ChipCE/IPMI-card/README.md

# IPMI-card
## To-do ( v3 )
1.Switch from ESP8266 to Raspberry Zero W
2.Add remote control via ssh

## To-do ( v3 lite )
1.Simple power control only using esp8266
