ChipCE/IPMI-card/std/Doc/outline.md

# PC遠隔制御(IPMI)カードの構築
## 1 はじめに
IPMIとはサーバのCPU、バス、ファン、温度センサ、電源、ファンなどの基本コンポーネントの監視や遠隔制御などを行うためのインターフェースである。しかし、市販のIPMIカードは特定のサーバマザーボードにしか対応しない。
本研究では一般ザーボードに対応できるIPMIモジュールを構築する。
## 2 システム構成
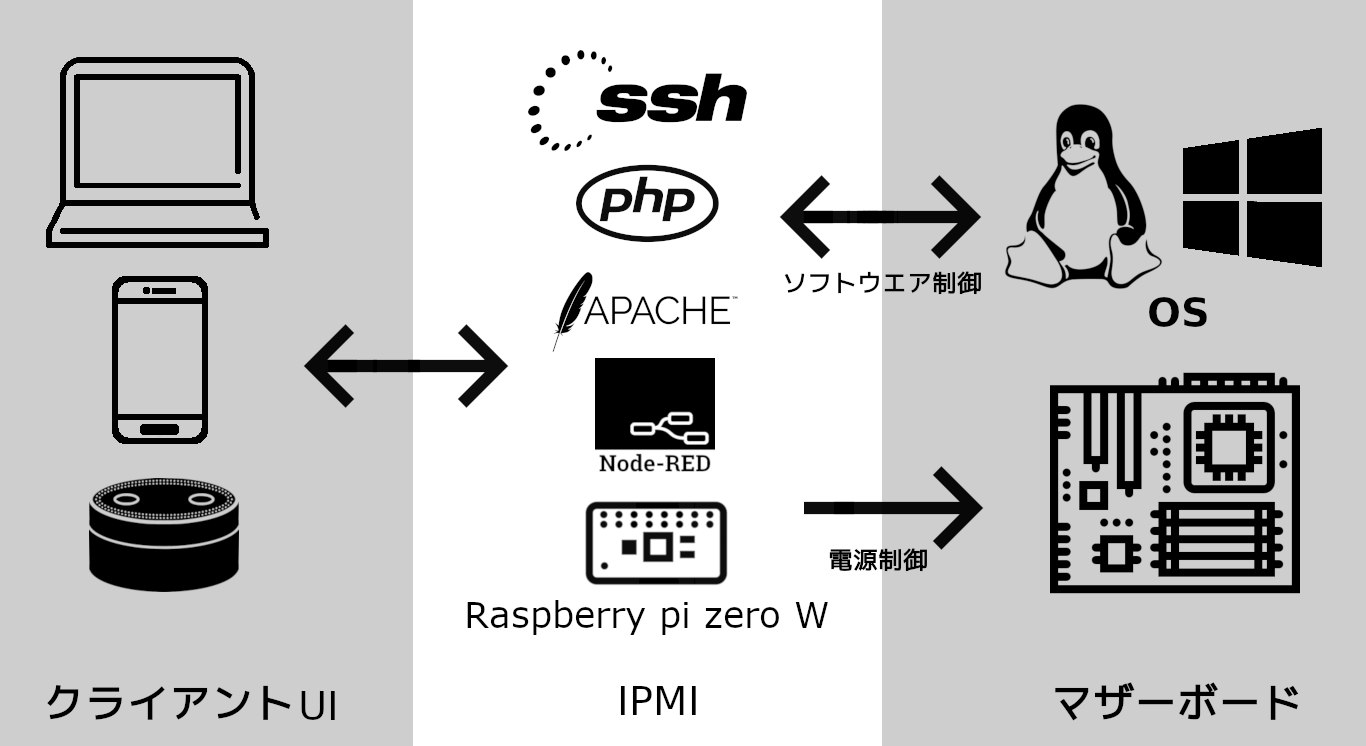
[picture p1: std/Doc/img/sys-map.png]

<center>図1．システム構成図</center>
- クライアントUI   
クライアントはスマホ、パソコンなどの端末でSSH、又はHttpプロトコルによってサーバーとデータをやり取りする。データの内容はホストPCの電源状態、IPMIモジュールの接続状態、ホストPCに実行させたい命令、命令実行の結果。
- IPMI   
IPMIモジュールはホストPCと独立の電源を使用、マザーボードの電源スイッチを物理的に操作することによって、ホストPCの電源状態と関係なく制御することができる。また、IPMIモジュールはUSBネットワークインタフェースとしてホストPCに接続することで、ホストPCがネットワークに接続しない状態でも遠隔操作ができる。
Apache+Php（ウエブサーバー）でクライアント端末にウエブインタフェースを提供する。スマートスピーカに関する処理はNode-redで行う。
使用可能なインタフェース：SSH,ウエブ
- ホストPC   
ホストPCはSSHプロトコルでIPMIモジュールから命令を受取、命令の実行結果をIPMIモジュールに送る。

## 3 ハードウェア制御
### 3.1 電源スイッチ制御回路
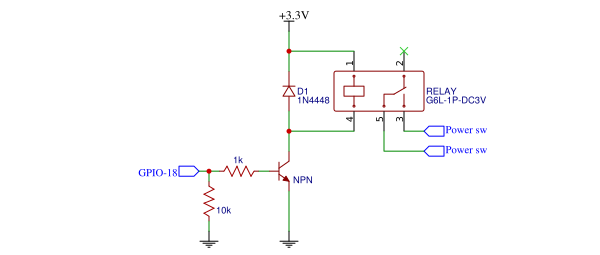
[picture p2: std/Doc/img/schem-relay.png]

<center>図2．電源制御回路図</center>
ホストPCの電源状態と関係なく制御するために、物理的にマザーボードの電源スイッチを操作することが必要と考えられる。電源スイッチを制御するためにリレーを用いる。リレーは電源スイッチと並列に接続する。リレーはホストPCの電源スイッチと並列接続することで、スイッチの機能を保ちながら、ホストPCの電源を制御することができる。
Raspberry Zero W GPIOの出力電力が低く、直接リレーを制御できないため、NPNトランジスタスイッチ回路リレーを制御する。
Raspberry Zero WのGPIO-18の初期化状態はINPUT－PULLDOWN（入力・プルダウン）ため、IPMIモジュールの起動、再起動ときにリレーの誤動作を生じないため、ホストPCの誤動作を防ぐことができる。

### 3.2 電源状態監視回路
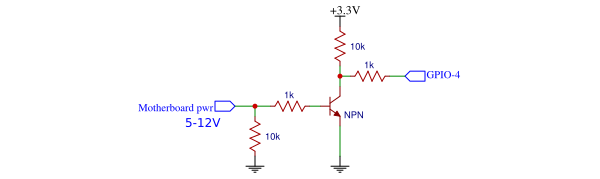
[picture p3: std/Doc/img/schem-monitor.png]

<center>図3．電源監視回路図</center>
マザーボードによって、電源を切ったときにも５Vバースに電源が供給される場合があるため。5VバースでホストPCの電源状態を判定できないときは12VバースでホストPCの電源状態を判定する。Raspberry Zeroの最大入力可能電圧は3.3Vのため、直接5v、12Vバースに直接接続せず、NPNトランジスタスイッチ回路で電源状態の判定を行う。NPNトランジスタスイッチ回路を使用することで入力電圧を大幅に対応することができる。

### 3.3 基板設計
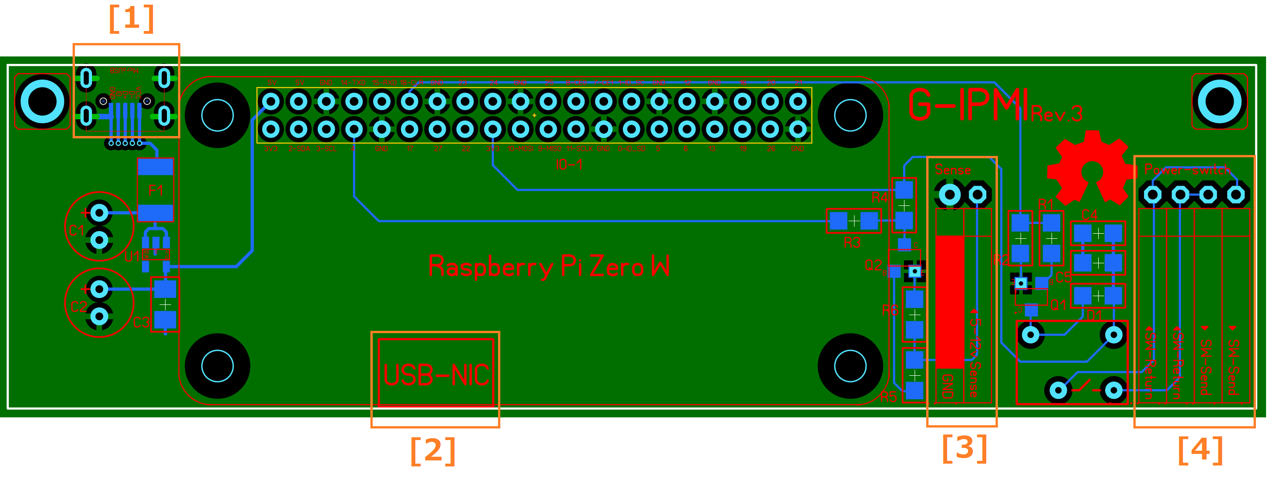
[picture p4: std/Doc/img/pcb.png]

<center>図4．基板設計図</center>
[1]電源入力：コネクタータイプはmicroUSB、電圧5v 電流 1000 mA以上
[2]Raspberryネットワークインターフェース:マザーボードのUSBヘッダに接続
[3]電源状態監視:マザーボードの電源スイッチヘッダやケースの電源スイッチに
接続
[4]電源スイッチ制御:マザーボードの5v、⼜は12v電源に接続
## 4 ソフトウェア制御
### 4.1 コマンドラインインターフェース(CLI)
ホストPCを遠隔操作するためにSSHプロトコルを利用する。ipmiモジュールにインストールされたipmiツールでほすとPCの電源やソフトウエア制御を行う。　　　
使用可能なコマンドライン:
- start :  ホストPCを起動する。
- stop :　ホストPCをシャットダウンする。
- restart : ホストPCを再起動する。
- status : ホストPCの状態を表示する。
- setup : ipmiモジュールの設定を行う。ホストPCをアクセスためのIPアドレスやWebインターフェースアクセスためのパスワードを変更することができる。
- shell : ホストPCのソフトウェア制御を行う。ホストPCがWindowsの場合はPowershell、Linuxの場合はbash/zshに接続する。
- version : ipmiのソフトウェアバージョンを表示。
- help : ipmiのマニュアルを表示。
- -f シャットダウン、再起動を強制に実行。シャットダウン、再起動の命令を実行後、一定の時間たってもホストPCの電源状態が変化しないとき強制的に電源を切る。
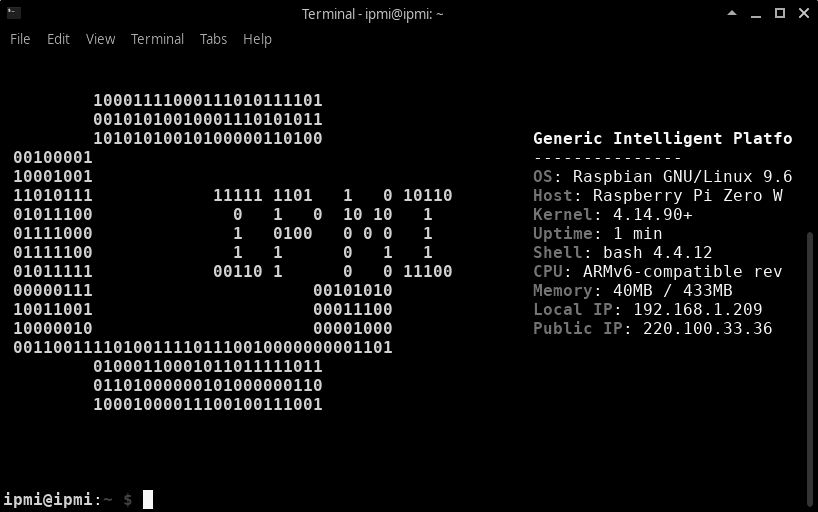
[picture p5: std/Doc/img/pc-cli-home.png]

<center>図5．パソコンのCLI</center> 
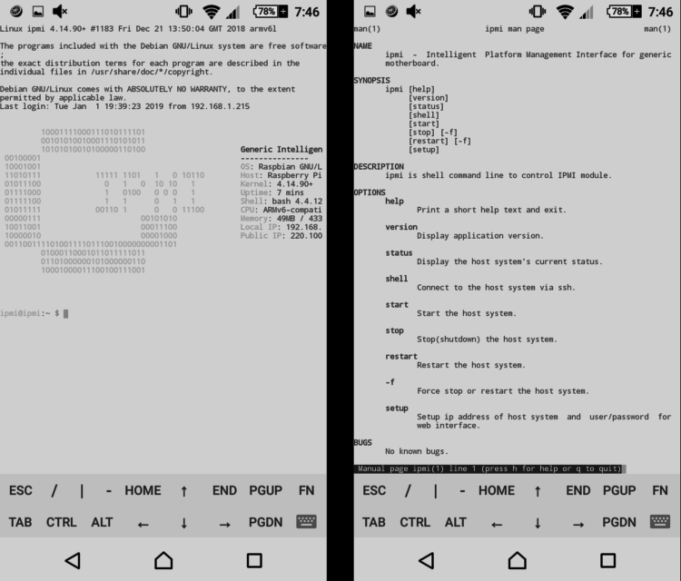
[picture p6: std/Doc/img/mobile-cli-all.png]

<center>図6．スマートフォンのCLI(ssh juiceアプリを利用)</center>

### 4.2 Webインインターフェース
WebインインターフェースでホストPCの監視や電源制御を行うことができる。WebインインターフェースはBootstrapフレームワークを利用することでアクセス端末の画面サイズによって適切なレイアウトを提供する。
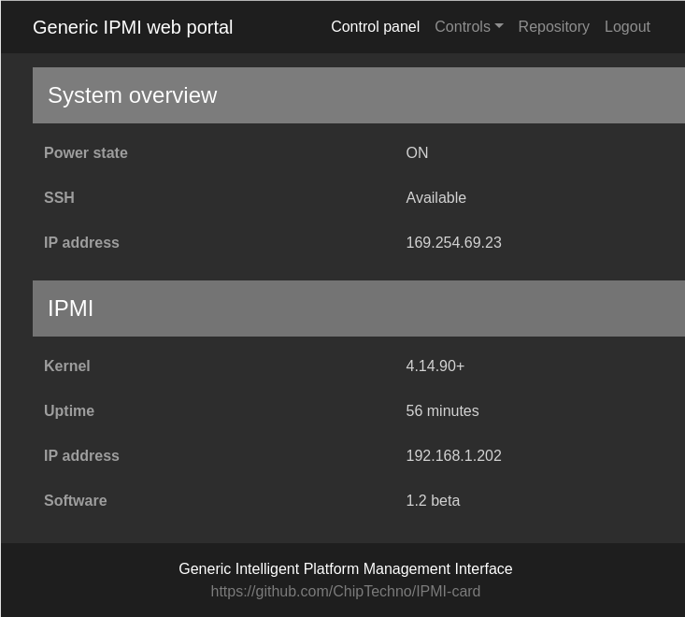
[picture p7: std/Doc/img/pc-web.png]

<center>図7．パソコンのWebインインターフェース</center>
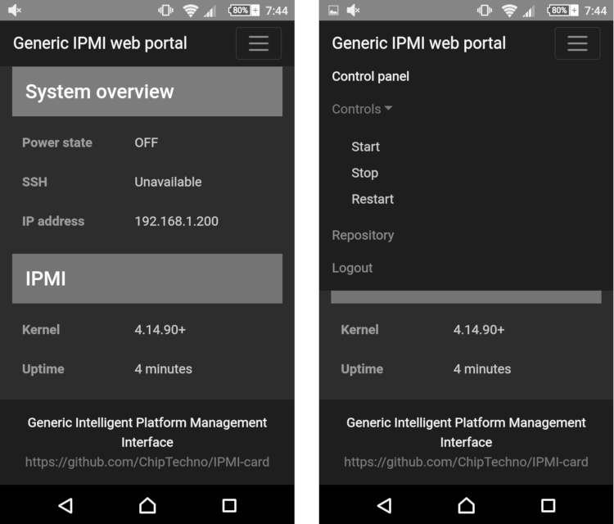
[picture p8: std/Doc/img/mobile-web-all.png]

<center>図8．スマートフォンのWebインインターフェース</center>

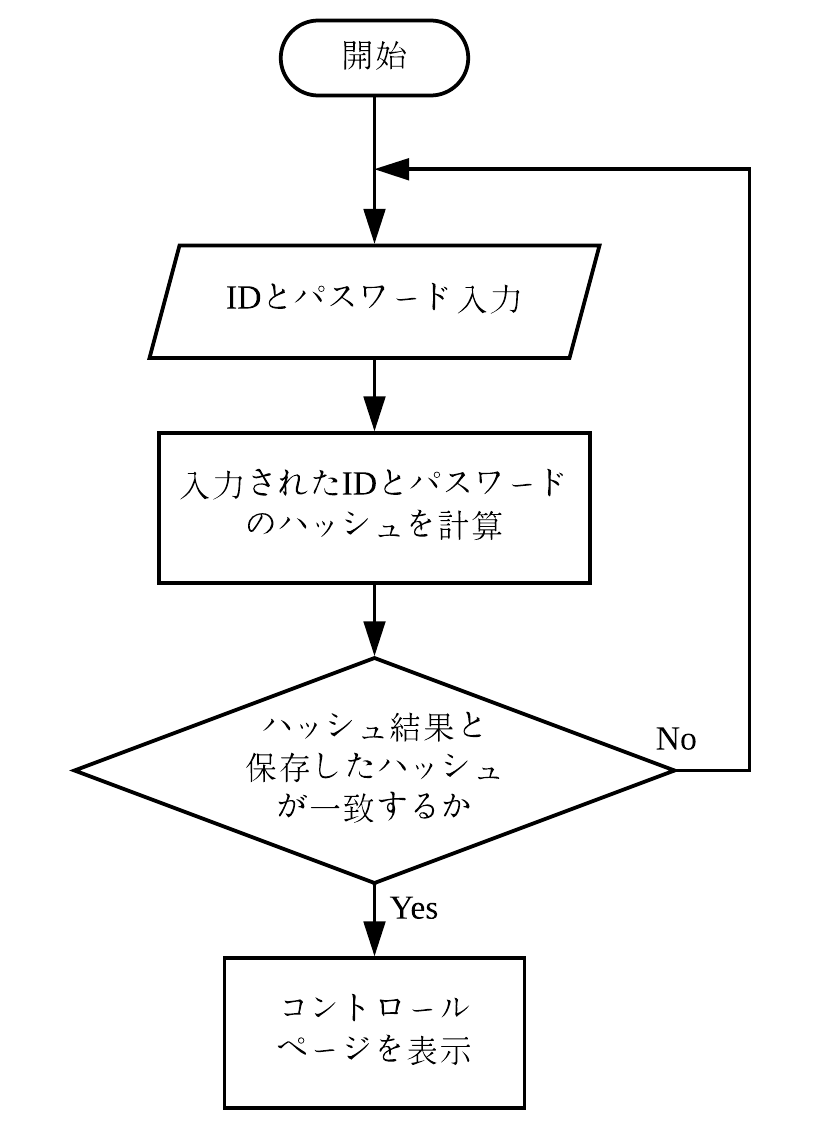
[picture p9: std/Doc/img/web-flowchart.png]
ipmi-flowchart

<center>図9.Webインタフェースの認証フローチャート</center>
WebインインターフェースをアクセスためにCLIと別のパスワードを入力することが必要。WebインインターフェースのIDやパスワードの設定はipmiのsetup機能で設定することができる。設定されたIDとパスワードはSHA256のハッシュ関数で暗号化しIPMIモジュールの設定ファイルに保存する。ユーザがIDとパスワードを入力したとき、そのIDとパスワードをSHA256のハッシュ関数で暗号化し、その結果を保存したハッシュ数を比較する。計算ハッシュと保存ハッシュが一致する場合、コントロールぺページに移動、一致しない場合は再入力を求める。

### 4.3 スマートスピーカーインインターフェース
スマートスピーカーインインターフェースはnoderedを利用、スマートスピーカーとの連携を行う。スマートスピーカーの音声認識機能でホストPCの電源制御を行うことができる。
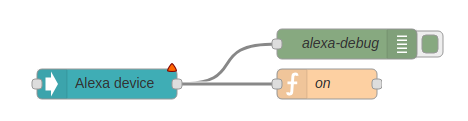
[picture p10: std/Doc/img/nodered.png]

<center>図10．NoderedによるAmazon echoとの連携</center>

## 6 動作確認
### 6.1 ペネトレーション・脆弱性テスト
ペネトレーションテストはroutersploit/autopwnを使い、ipmiモジュールの脆弱性を検知するを行った。2019年1月7日の実行は「脆弱性が発見されなかった(could not confirm any vulnerablity.)」という結果を得た。

ipmi-flowchart
<center>図11．routersploit/autopwnによるペネトレーション・脆弱性テスト結果</center>

### 6.2 消費電力測定
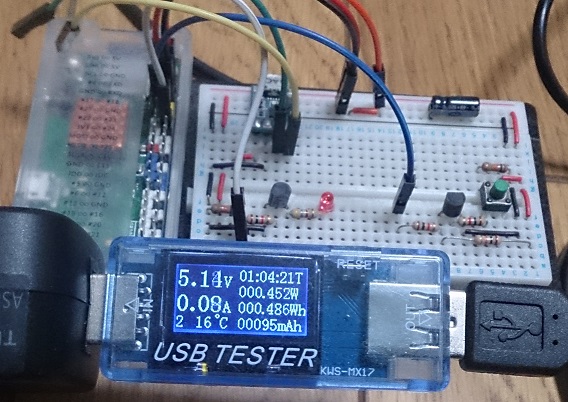
[picture p11: std/Doc/img/power-consumption.png]

<center>図12．消費電力テスト結果</center>

## 5 まとめ
本研究でRaspberry Zero Wを用いてパソコン遠隔操作装置（IPMI）の構築を行った。作成した装置で、ホストPCの電源やネットワーク状態と関係なく遠隔操作を行うことができた。
　本研究で使用したRaspberry Zero WはネットワークインターフェースカードとしてホストPCのマザーボードに接続するため、OSが起動する前（BIOS）段階で電源制御以外の遠隔操作機能は使用できない。今後の課題として、Biosの設定画面にも遠隔操作を行うことができれば、利便性が向上すると考えられる。

## 参考文献
[1] BCM2835-ARMデータシート
https://www.raspberrypi.org/app/uploads/2012/02/BCM2835-ARM-Peripherals.pdf(2018年12月1日閲覧)
[2] routersploit/autopwnによるペネトレーションテストツール(2019年1月8日閲覧)
https://github.com/threat9/routersploit
