ChipCE/IPMI-card/std/Doc/final/memo.md

# Memo

## To be include in main.md

- web auth flow chart
- power control flow chart
- sys schematic (gpio control and ideal diode)
- Security test
- Control test
- install script map
- device specs
- linux gpio group

## fix

- enable nodered and apache systemd service
- cleanup echo from code
- check version in web,shell,man,python scripts
