ChipCE/IPMI-card/std/Doc/final/参考文献-謝辞.docx

参考文献

[1] BCM2835-ARMデータシート

https://www.raspberrypi.org/app/uploads/2012/02/BCM2835-ARM-Peripherals.pdf

(2018年12月1日閲覧)

[2] routersploit/autopwnペネトレーションテストツール

https://github.com/threat9/routersploit

(2019年1月8日閲覧)

[3] Bootstrap 4 API

https://getbootstrap.com/docs/4.1/getting-started/introduction/

(2019年1月8日閲覧)

[4] Raspberry Pi ドキュメント

https://www.raspberrypi.org/documentation/

(2019年1月8日閲覧)

謝辞

本研究を進めるにあたり、研究設備を整えて下さり、また終始懇切丁寧にご指導・ご助言下さった、山本政宏先生に心より深く感謝し、お礼申し上げます。

また、様々なご意見をいただきました先輩方々や同級生の方々に深く感謝いたします。
