ChipCE/IPMI-card/std/Doc/final/付録目次.docx

付録目次

1. index.php 1
2. ipmi-bridge.php 5
3. login-action.php 6
4. login.php 　　 7
5. logout.php 10
6. msg.php 11
7. style.css 14
8. IPMI man 16
9. Neofetch config 18
10. Neofetch 21
11. IPMI config 22
12. ipmi.py 23
13. ipmi.sh 27
14. setup.sh 32
