ChipCE/IPMI-card/std/Doc/final/本文目次.docx

目次

1 はじめに 1
2 システム構成 2
3 電源制御 3
4 コマンドラインインターフェース 4
5 ウェブインターフェース 8
6 スマートスピーカーインターフェース 10
7 動作テスト 11
8 回路設計 16
9 まとめ 17

参考文献

謝辞

付録
