ChipCE/IPMI-card/std/Doc/final/表紙.docx

2019年度　卒業論文

PC遠隔制御(IPMI)カードの構築

関東学院大学　理工学部理工学科

情報ネット・メディアコース

山本研究室

215K6036 グェンミントゥ
