ChipCE/IPMI-card/std/Doc/img/access-key.png

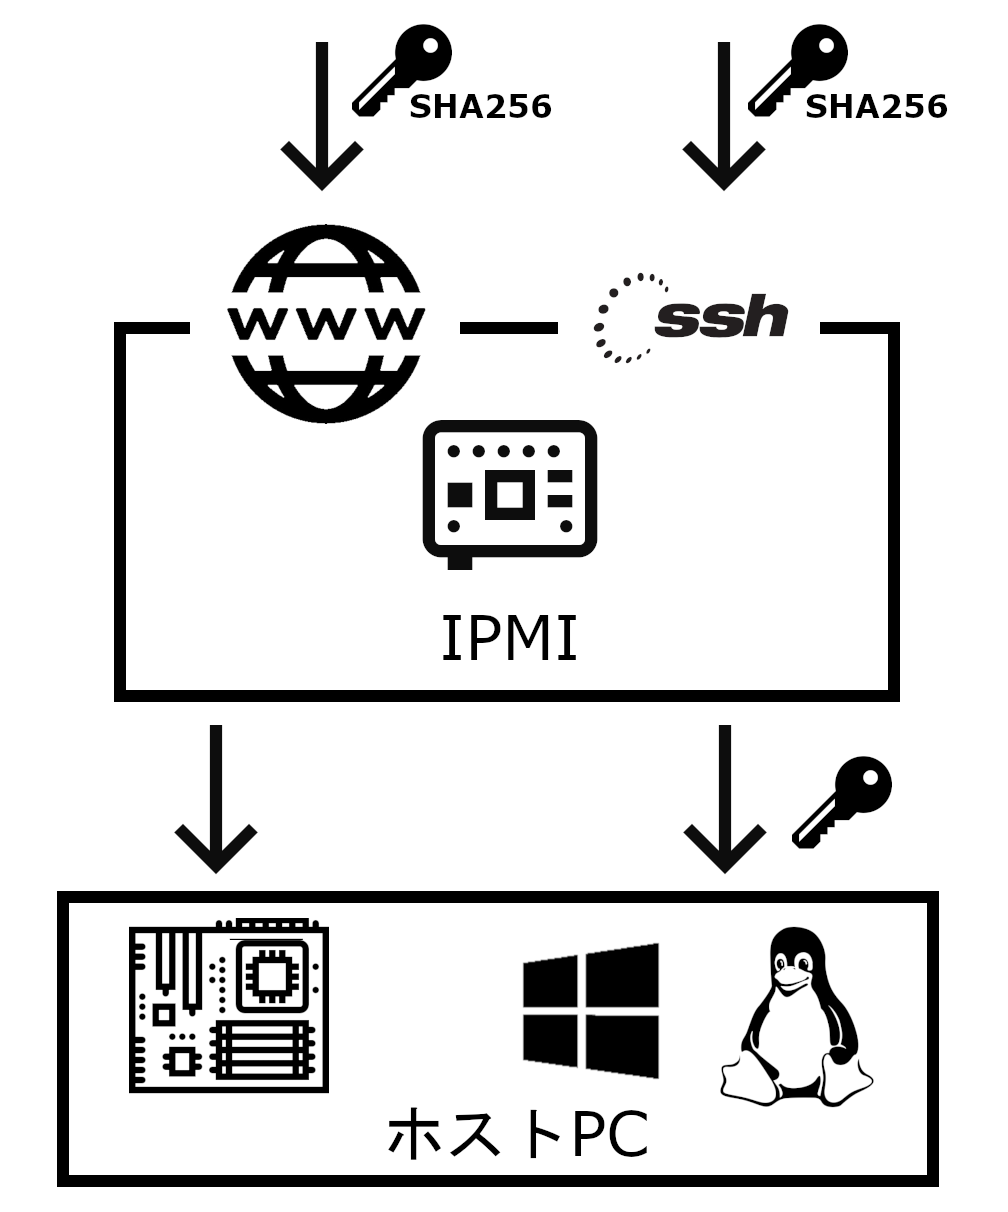
std/Doc/img/access-key.png
