ChipCE/IPMI-card/std/Doc/img/esp8266.png

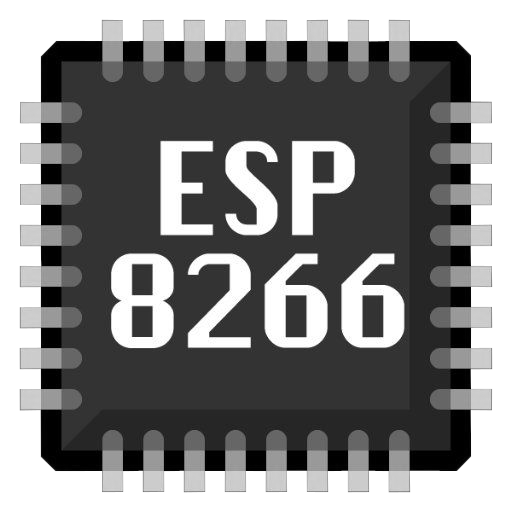
std/Doc/img/esp8266.png
