ChipCE/IPMI-card/std/Doc/img/hp-ipmi-back-front.jpg

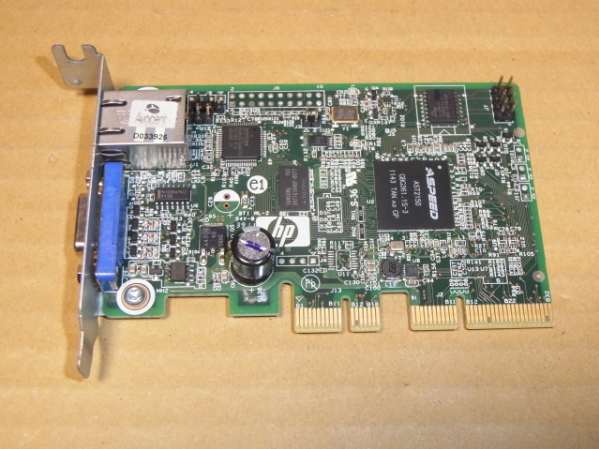
std/Doc/img/hp-ipmi-back-front.jpg
