ChipCE/IPMI-card/std/Doc/img/hp-ipmi-back.jpg

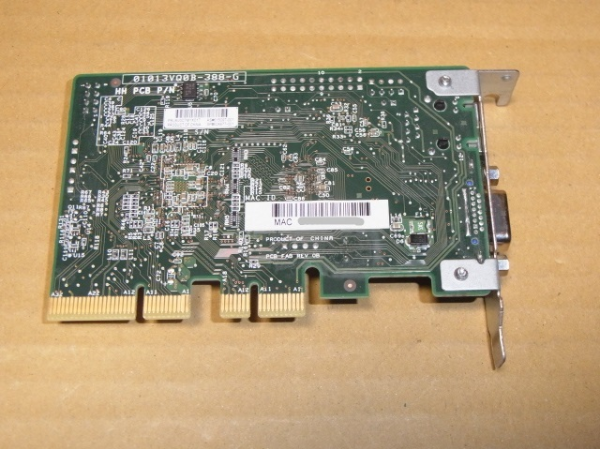
std/Doc/img/hp-ipmi-back.jpg
