ChipCE/IPMI-card/std/Doc/img/hp-ipmi.jpg

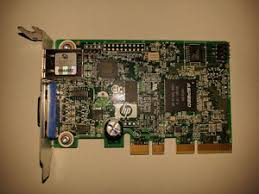
std/Doc/img/hp-ipmi.jpg
