ChipCE/IPMI-card/std/Doc/img/mobile-cli-home.png

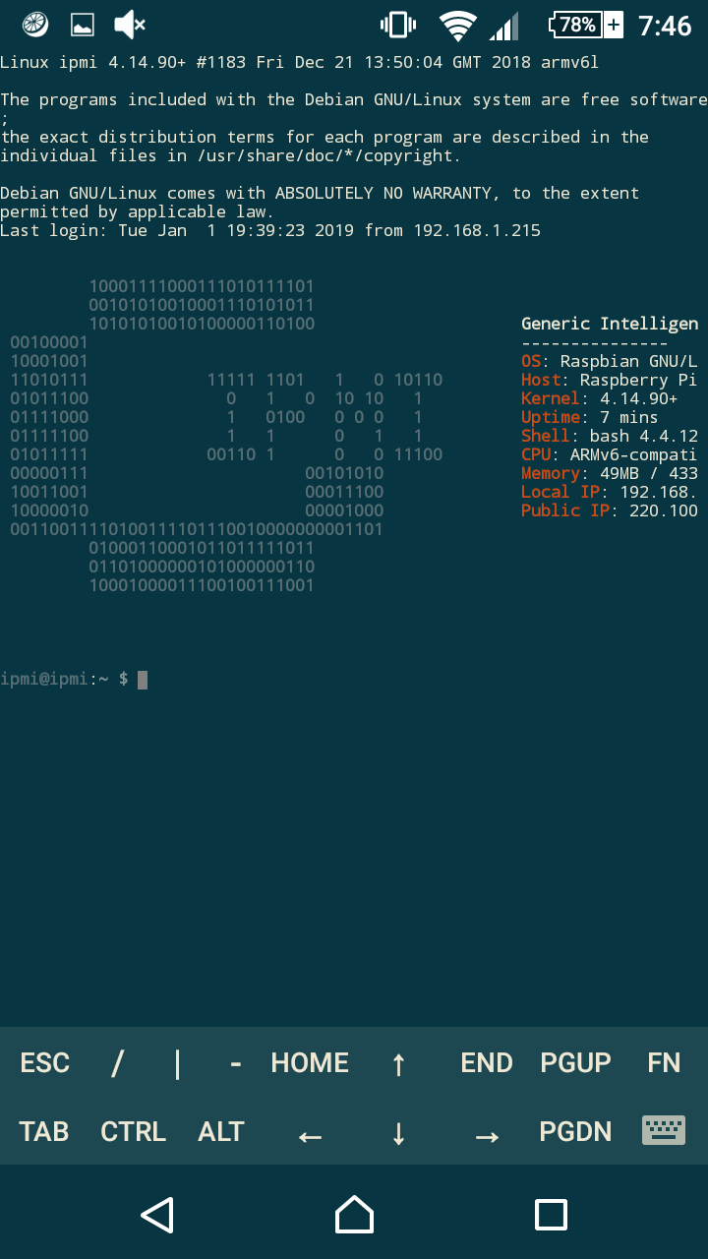
std/Doc/img/mobile-cli-home.png
