ChipCE/IPMI-card/std/Doc/img/mobile-cli-man.png

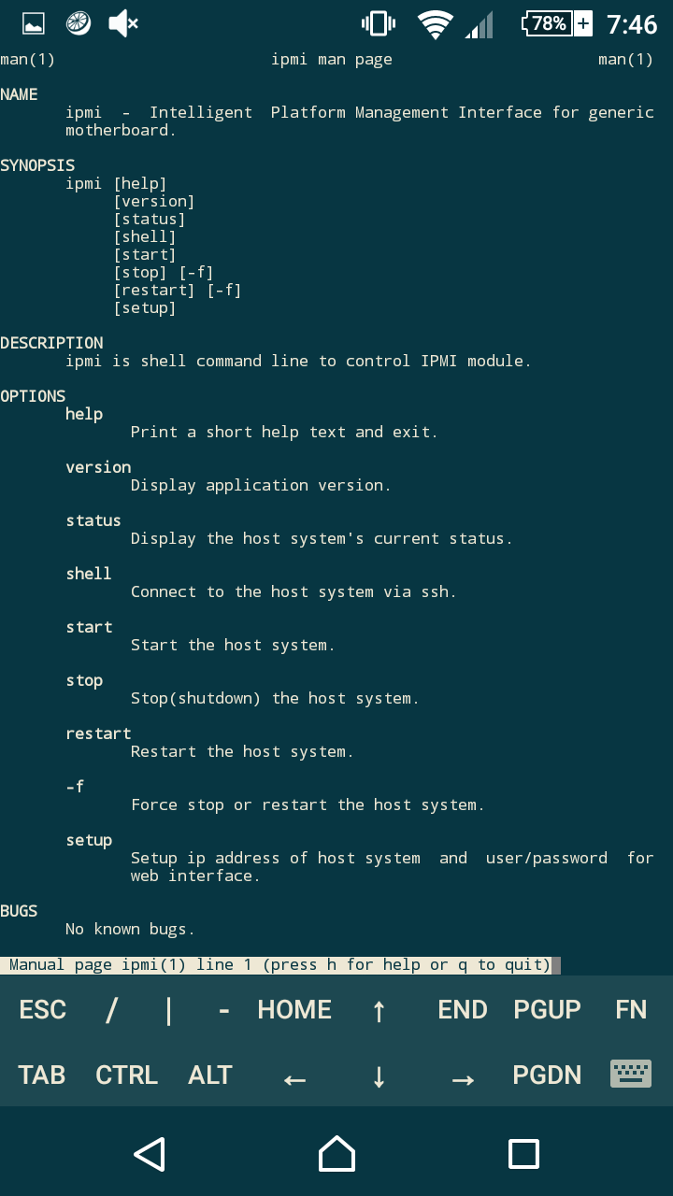
std/Doc/img/mobile-cli-man.png
