ChipCE/IPMI-card/std/Doc/img/mobile-web-control.png

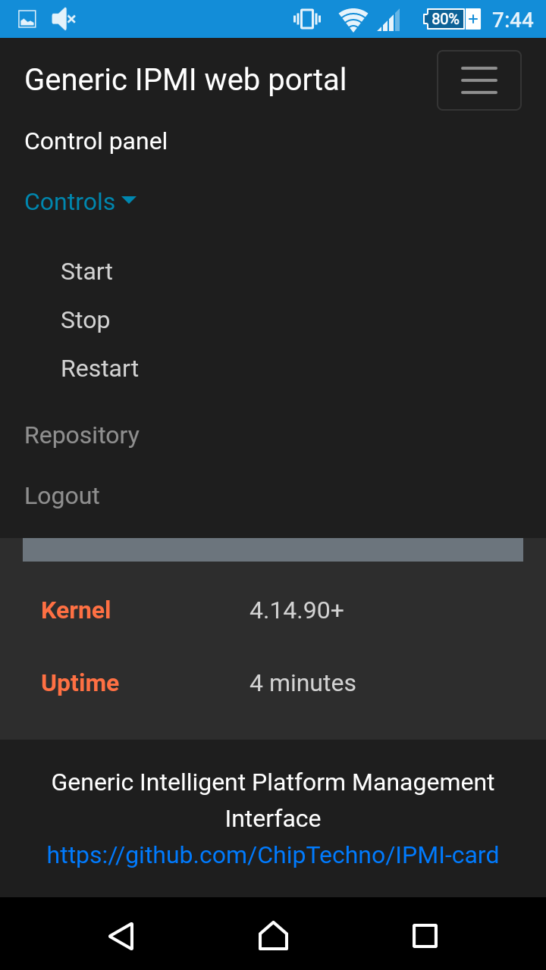
std/Doc/img/mobile-web-control.png
