ChipCE/IPMI-card/std/Doc/img/mobile-web-home.png

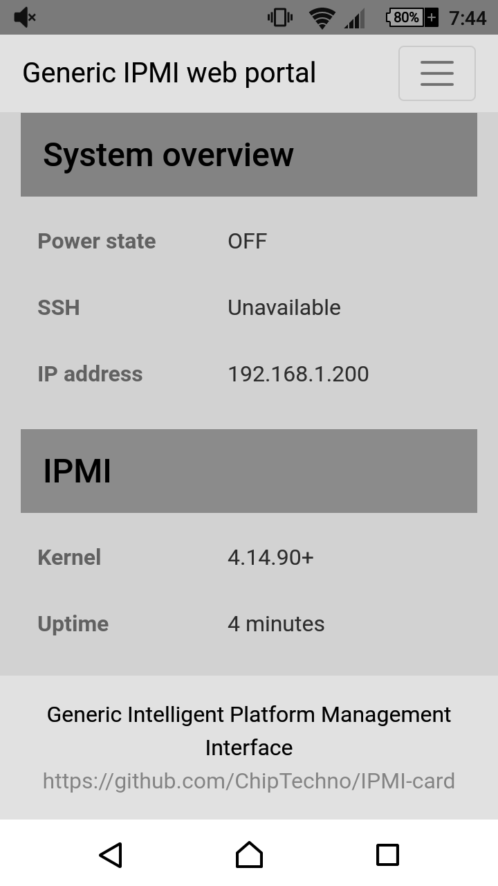
std/Doc/img/mobile-web-home.png
