ChipCE/IPMI-card/std/Doc/img/net-map.png

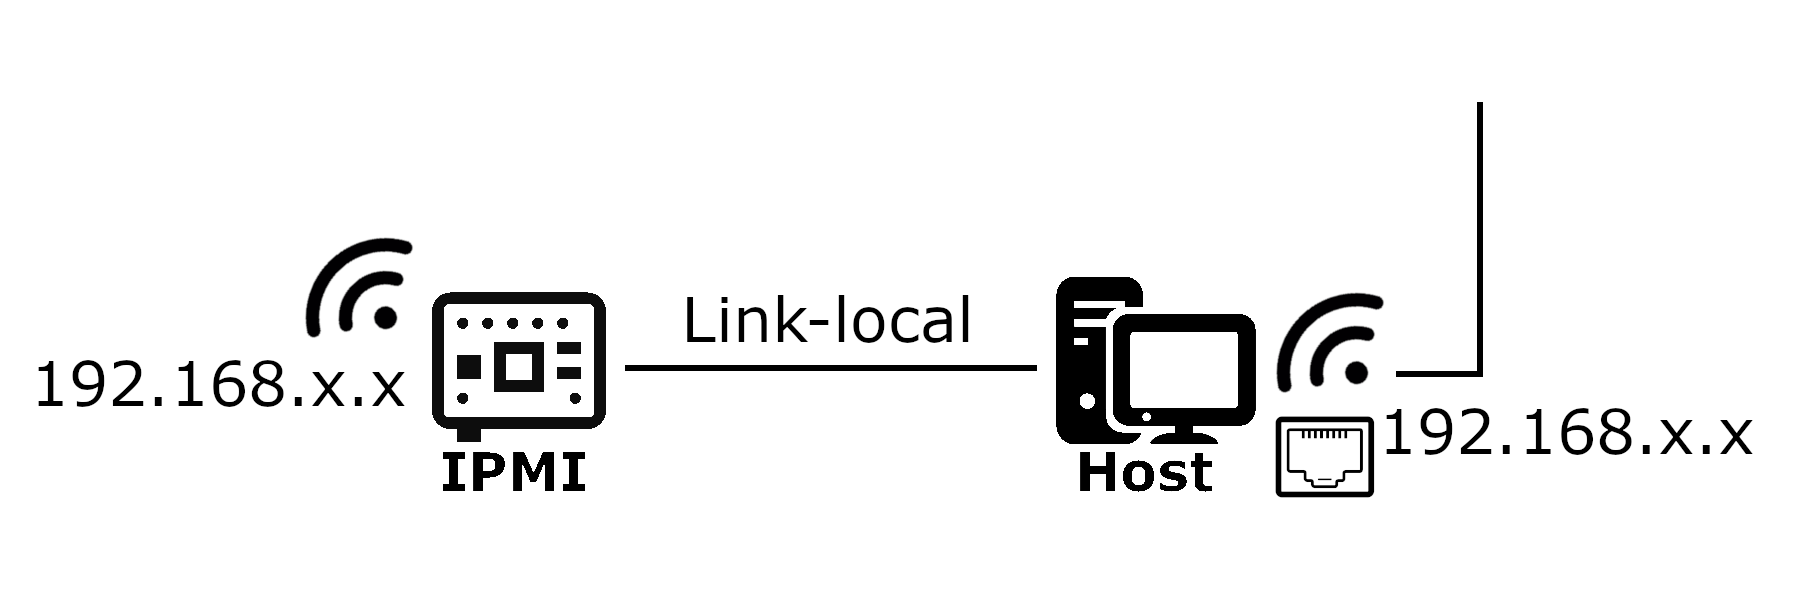
std/Doc/img/net-map.png
