ChipCE/IPMI-card/std/Doc/img/none.png

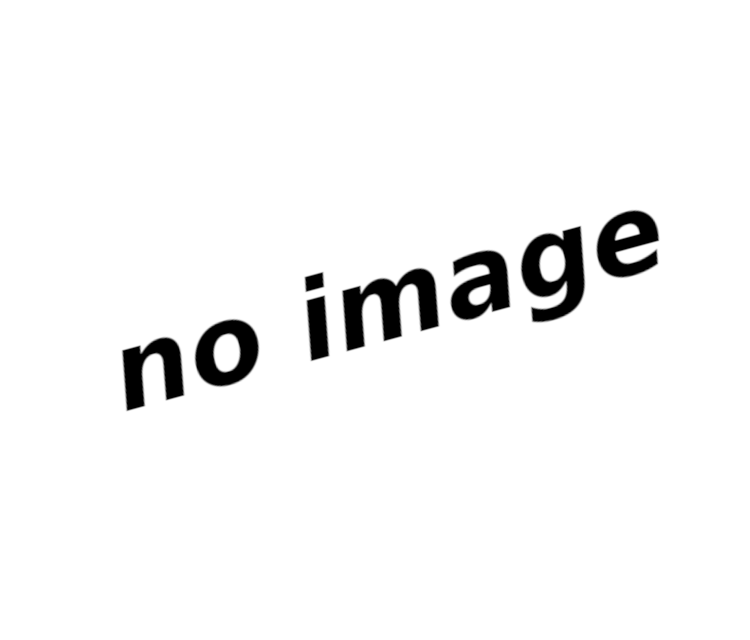
std/Doc/img/none.png
