ChipCE/IPMI-card/std/Doc/img/openssh-linux.png

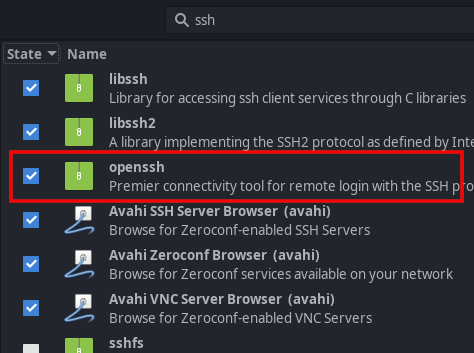
std/Doc/img/openssh-linux.png
