ChipCE/IPMI-card/std/Doc/img/openssh-win10.png

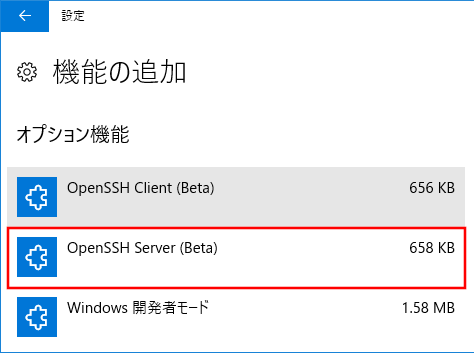
std/Doc/img/openssh-win10.png
