ChipCE/IPMI-card/std/Doc/img/putty.png

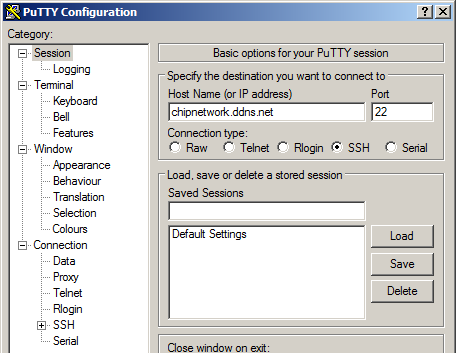
std/Doc/img/putty.png
