ChipCE/IPMI-card/std/Doc/img/schem-simple.png

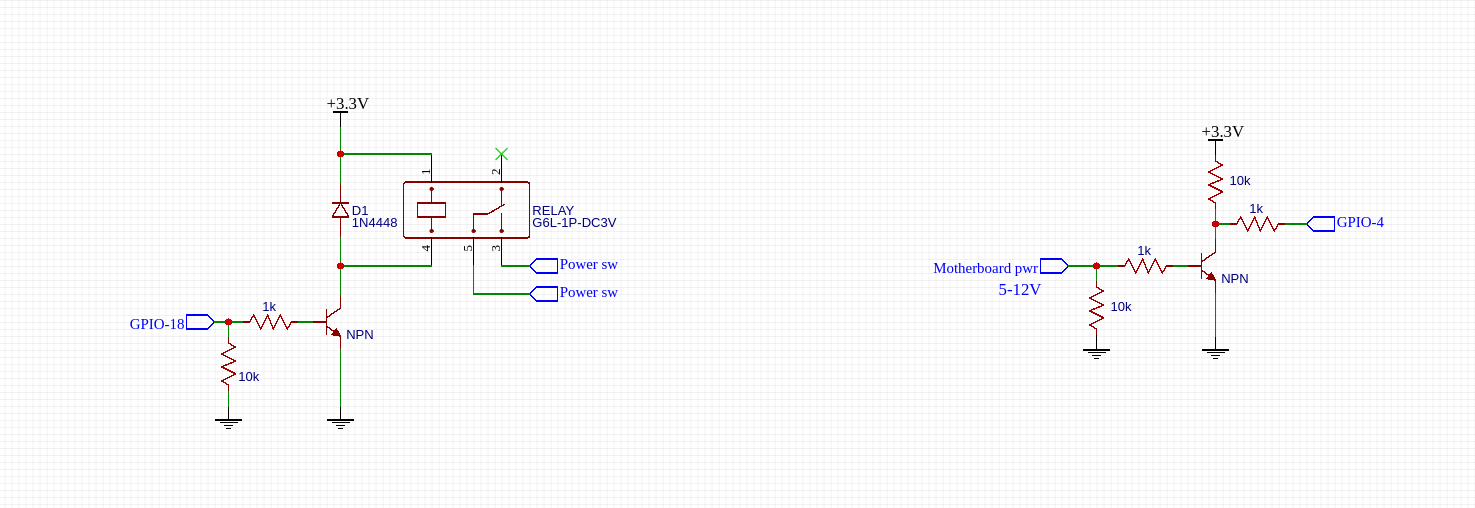
std/Doc/img/schem-simple.png
