ChipCE/IPMI-card/std/Doc/img/v1.jpg

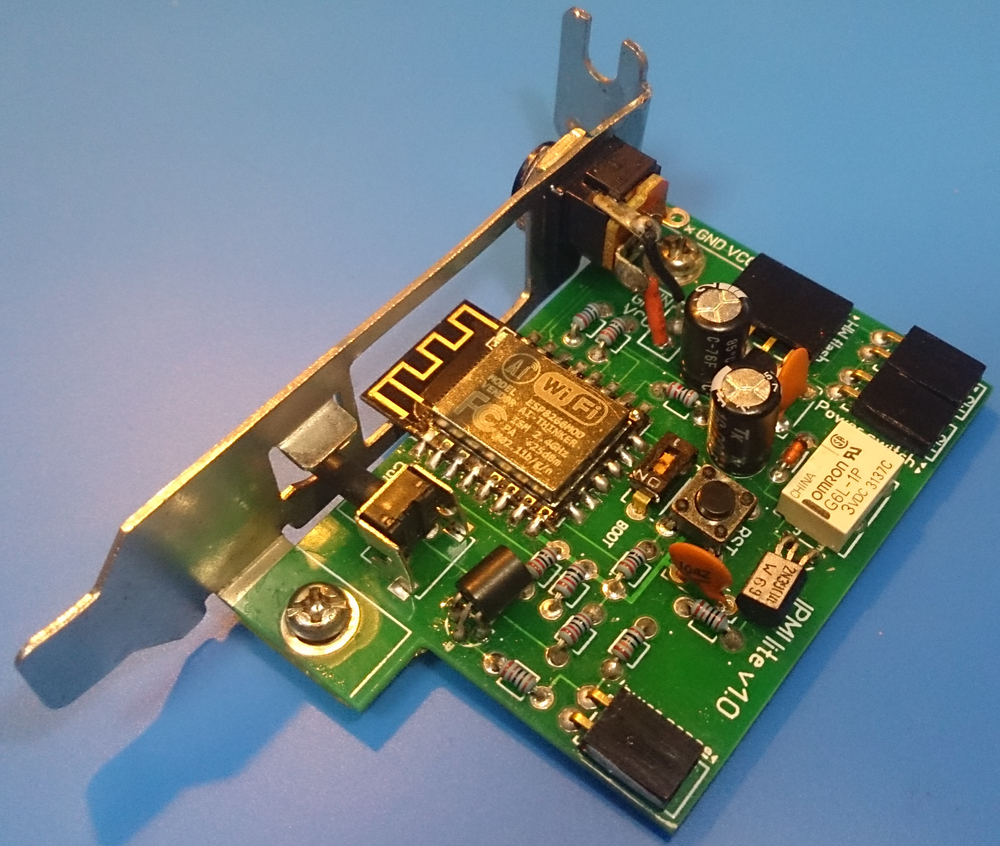
std/Doc/img/v1.jpg
