ChipCE/IPMI-card/std/Doc/img/v2.jpg

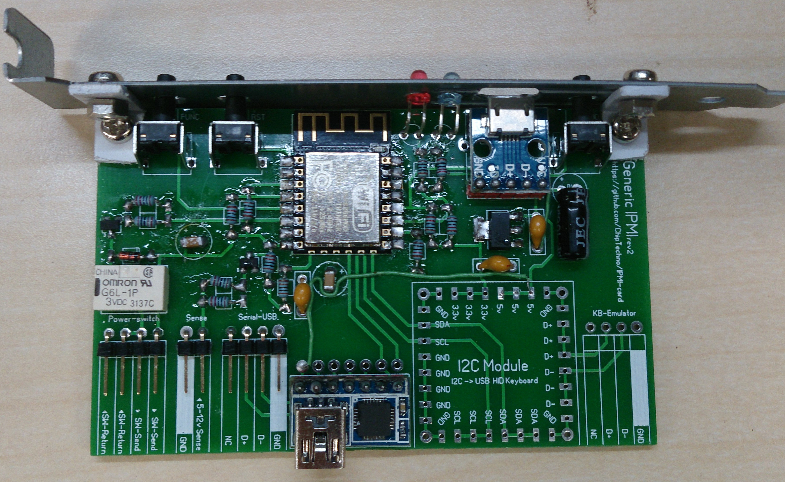
std/Doc/img/v2.jpg
