ChipCE/IPMI-card/std/Doc/img/v3.jpg

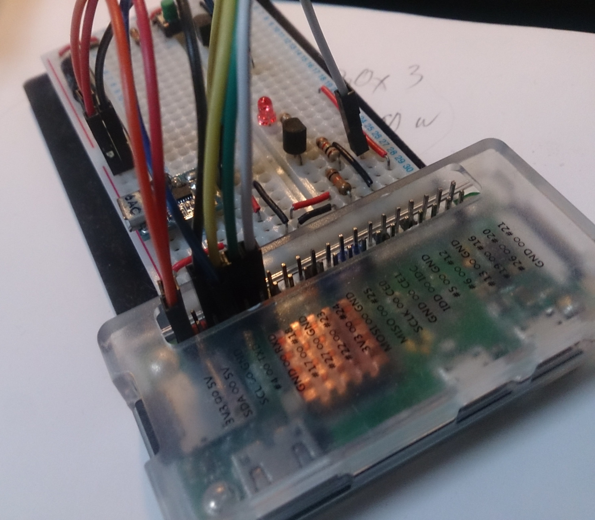
std/Doc/img/v3.jpg
