ChipCE/IPMI-card/std/Doc/img/v123.jpg

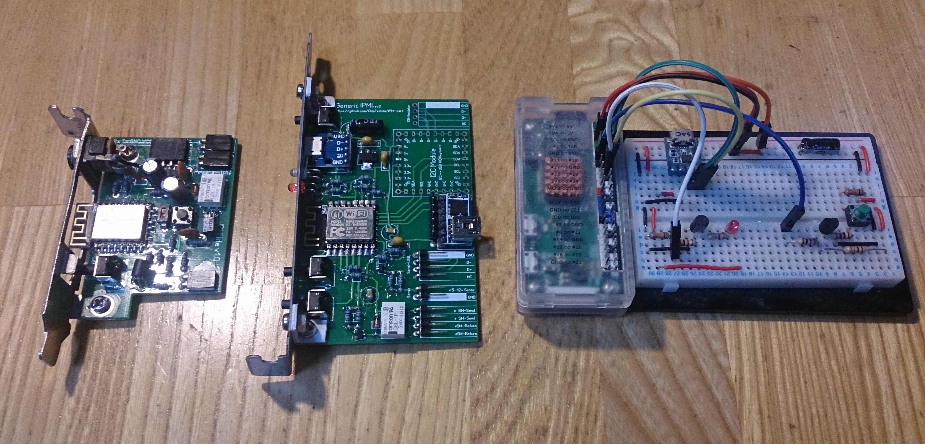
std/Doc/img/v123.jpg
