ChipCE/IPMI-card/std/Doc/img/video-client.png

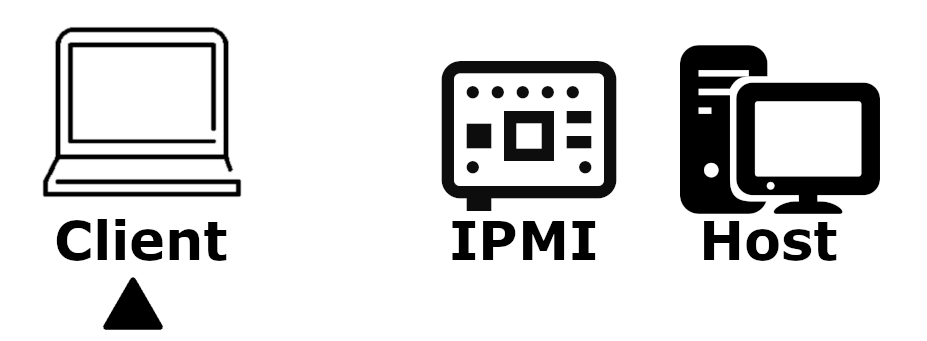
std/Doc/img/video-client.png
