ChipCE/IPMI-card/std/Doc/img/web-combined.png

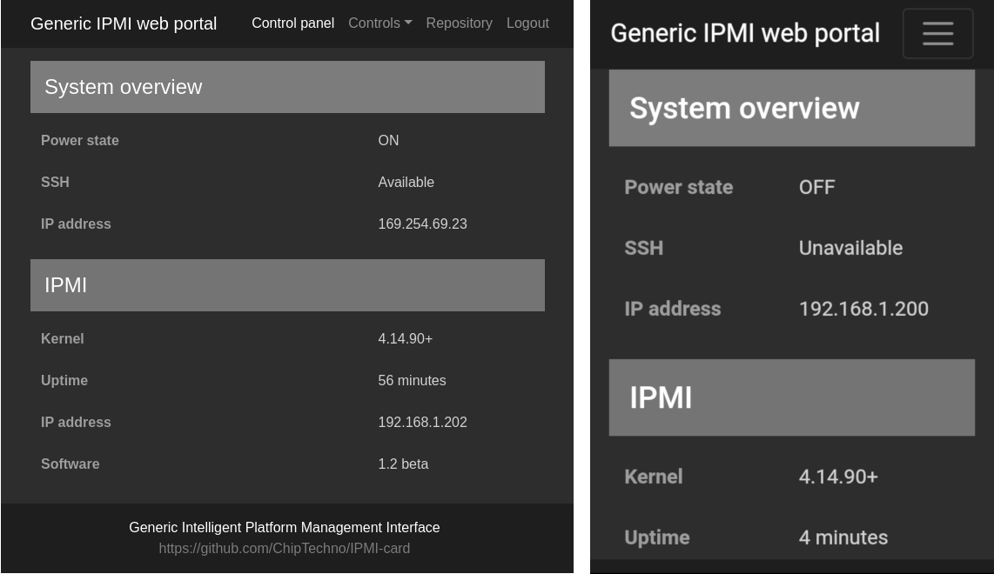
std/Doc/img/web-combined.png
