ChipCE/IPMI-card/std/Doc/img/web-pc.png

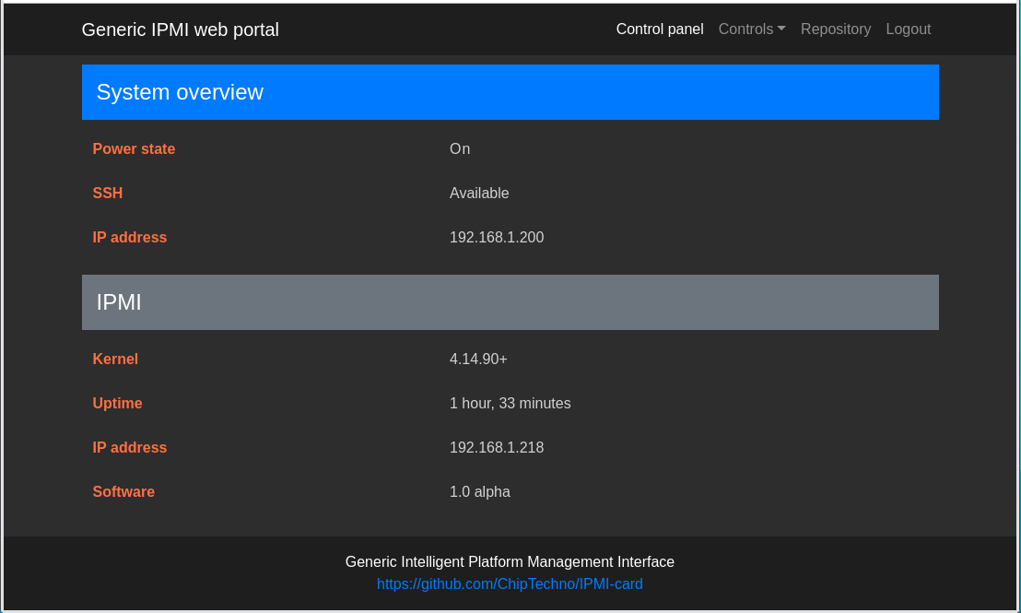
std/Doc/img/web-pc.png
