ChipCE/IPMI-card/std/Doc/tmp-img/1583948-200.png

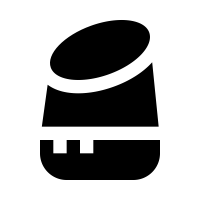
std/Doc/tmp-img/1583948-200.png
