ChipCE/IPMI-card/std/Doc/tmp-img/download (1).png

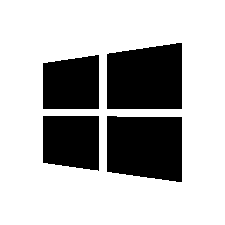
std/Doc/tmp-img/download (1).png
