ChipCE/IPMI-card/std/Doc/tmp-img/download.png

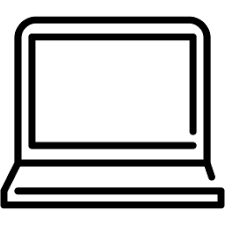
std/Doc/tmp-img/download.png
