ChipCE/IPMI-card/std/Doc/tmp-img/img_476336.png

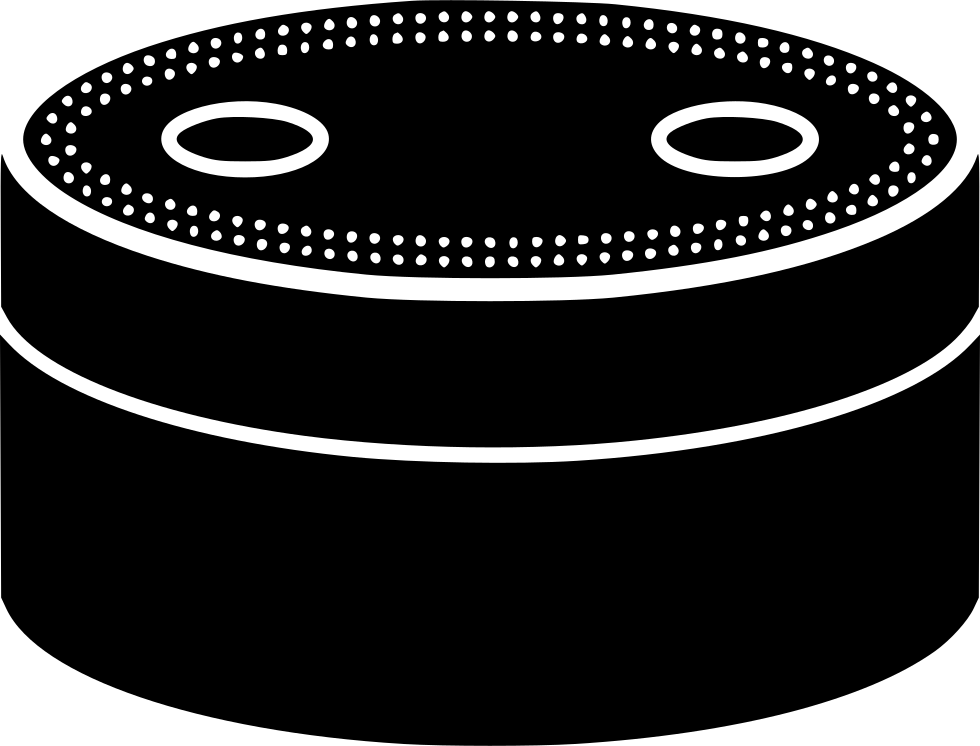
std/Doc/tmp-img/img_476336.png
