ChipCE/IPMI-card/std/Doc/tmp-img/mosquitto.png

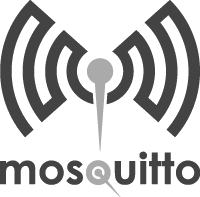
std/Doc/tmp-img/mosquitto.png
