ChipCE/IPMI-card/std/Doc/tmp-img/motherboard.png

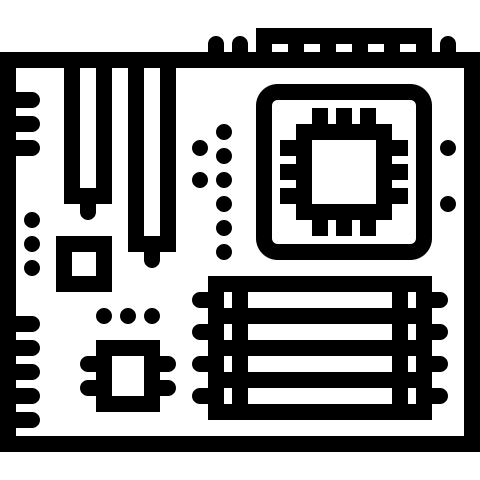
std/Doc/tmp-img/motherboard.png
