ChipCE/IPMI-card/std/Doc/tmp-img/raspberry-pi-zero.png

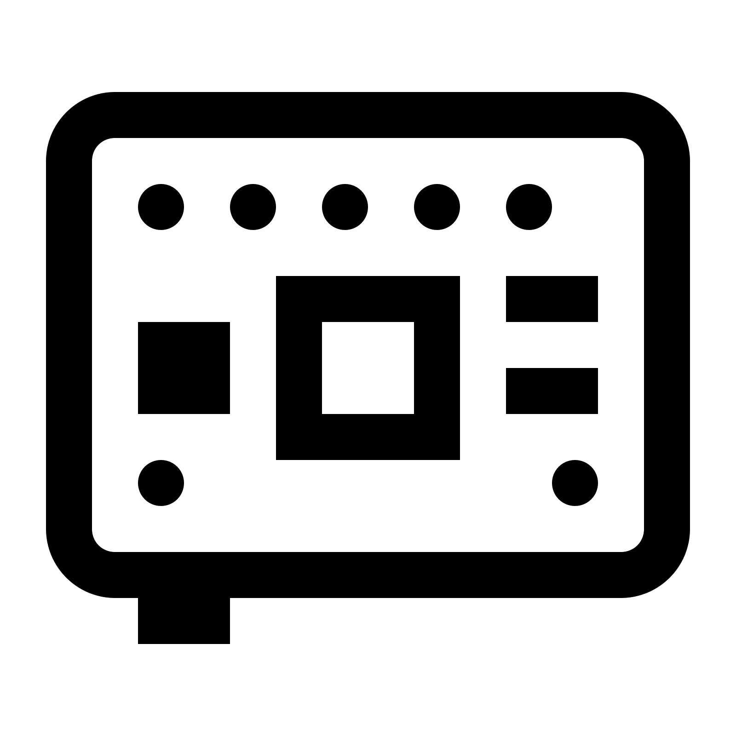
std/Doc/tmp-img/raspberry-pi-zero.png
