ChipCE/IPMI-card/std/Doc/tmp-img/web.png

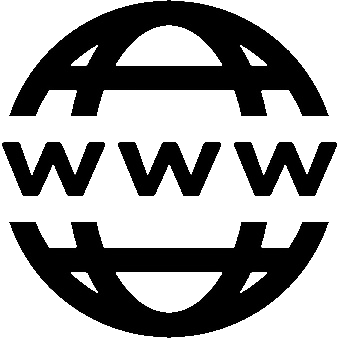
std/Doc/tmp-img/web.png
