ChipCE/IPMI-card/(list of files, drawings)

Other design files:
gerber/ipmiv2.la(fixed)y6.lay6
Old versions/gerber/ipmiv2.la(fixed)y6.lay6
std/ipmiv3.lay6
