ChipCE/IPMI-card/firmware/HardwareController.h

#ifndef __HARDWARE_CONTROLLER_H
#define __HARDWARE_CONTROLLER_H
#include <Arduino.h>

//define PIN
#define SENSE 13
#define RELAY 12
#define LED 2

//define time threshold
#define BUTTON_CLICK_INTERVAL 300


class HardwareController
{
    private:
        bool ledStatus;
        unsigned long hearbeatTimer;

    public:
        HardwareController();
        void nonBlockDelay(unsigned long millisecond);
        bool getPowerState();
        bool switchPower();
        void switchLed(bool status);
        void heartBeat();
        void handleHardware();
        void cancel();
};

#endif
