ChipCE/IPMI-card/(commit log)

2018-02-17 layout and source update
    Change sense pin to reverse.
    Update layout. v1.0
    [layout.lay6]
2018-02-24 export gerber
    [layout.lay6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]
2018-03-13 update layout v1.1
    fix drill hole size of transistors
    [layout.lay6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]
2018-06-26 comple ui, config manager, serial manager
    i used
    CheckForIllegalCrossThreadCalls = false; to cheat the cross thread control.Will thix this later
2018-08-18 daily commit
    [ipmiv2.lay6]
2018-08-19 updates layout v2(beta)
    [ipmiv2.lay6]
2018-09-03 layout rev3
    [ipmiv2rev3.lay6]
2018-09-16 clean up
    [ipmiv2.la(fixed)y6.lay6, ipmiv2.lay6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]
2018-09-17 fixed A LOT of bugs
    [IpmiSerialController.cpp, firmware.ino]
2018-10-02 fixed Conf button bug
    [firmware.ino]
